WROMagnet/Tereneitor_PR/Parts/Pico Robot Expansion Board.png

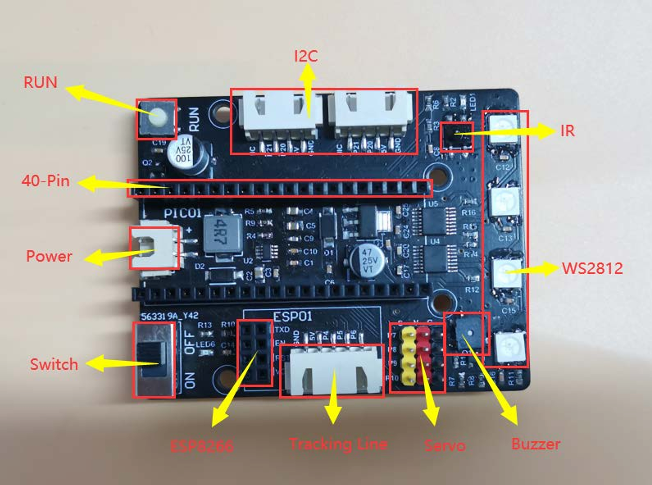
Parts/Pico Robot Expansion Board.png
