WROMagnet/Tereneitor_PR/Parts/Wheels x4.png

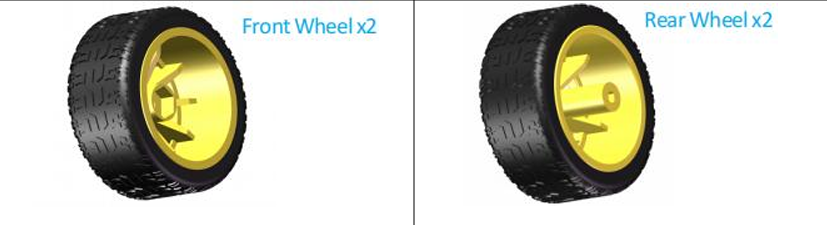
Parts/Wheels x4.png
