WROMagnet/Tereneitor_PR/README.md

# Tereneitor_PR | Future Engineers | Puerto Rico🤖

## Competitors of this team
- Daniel Roman Rodriguez - `18 years old`
- Luis Rios Santos - `18 years old`

## Content 📘  

| Folder  | Content| 
| -- | -- |
|
