WROMagnet/Tereneitor_PR/Parts/3.7V Lithium-ion batteries.jpg

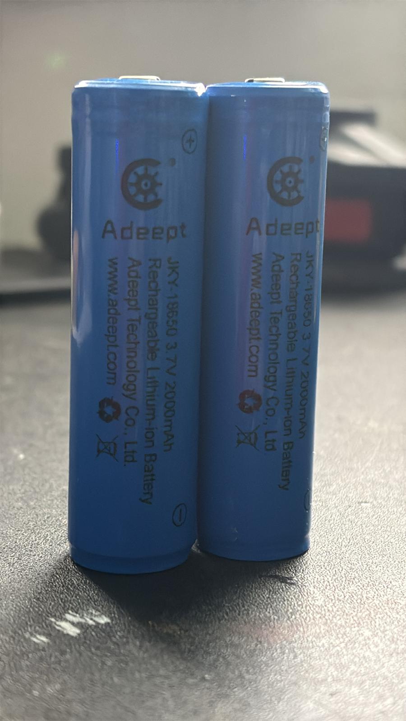
Parts/3.7V Lithium-ion batteries.jpg
