WROMagnet/Tereneitor_PR/Parts/Raspberry Pi Pico.png

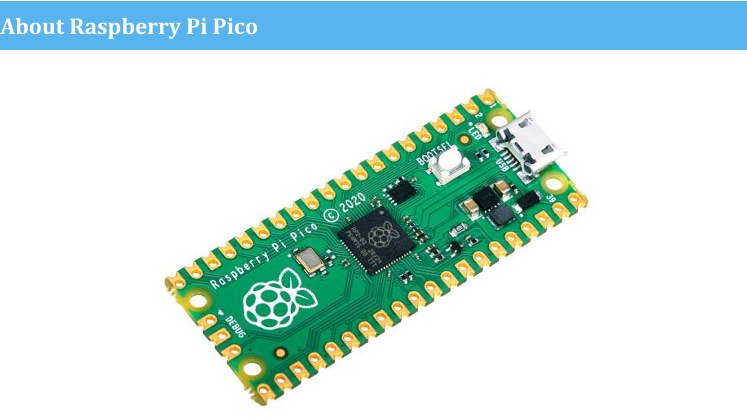
Parts/Raspberry Pi Pico.png
