WROMagnet/Tereneitor_PR/Parts/sensor TCS3200.jpg

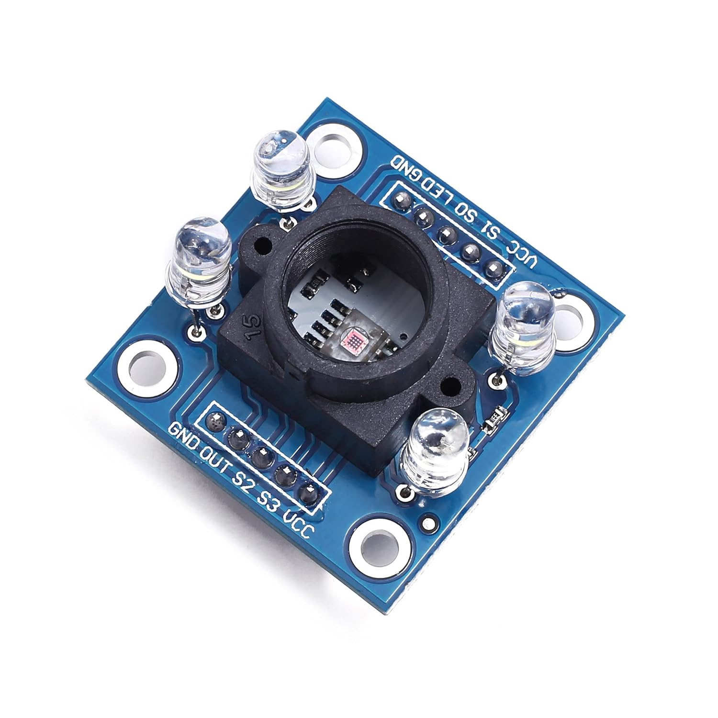
Parts/sensor TCS3200.jpg
