WROMagnet/Tereneitor_PR/3D Models/Base below.stl

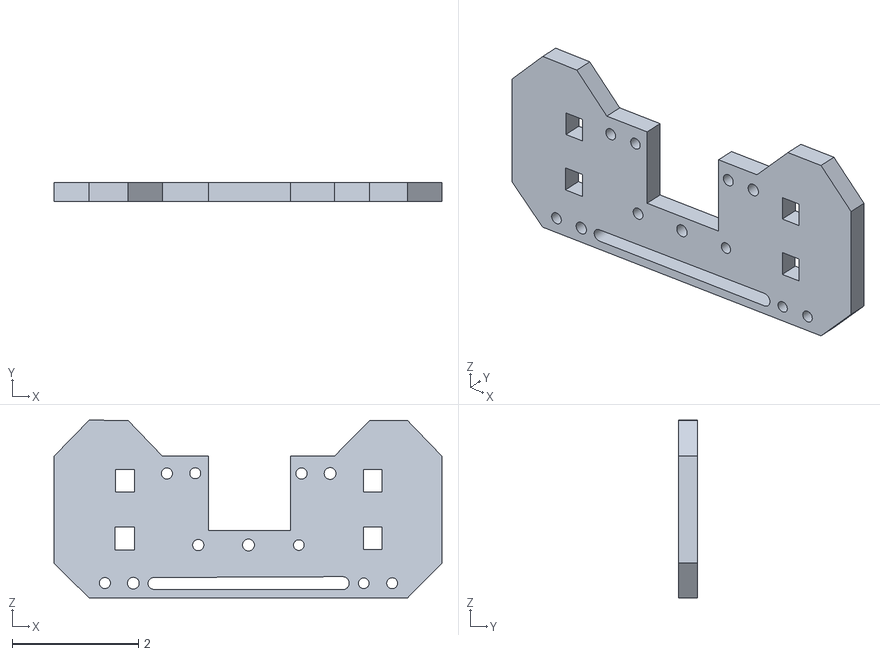
[picture p6: CAD file, 2025-03-30]
3D Models/Base below.stl
6.15 x 0.3 x 2.82
