WROMagnet/Tereneitor_PR/3D Models/Differential connectors/connectors.stl

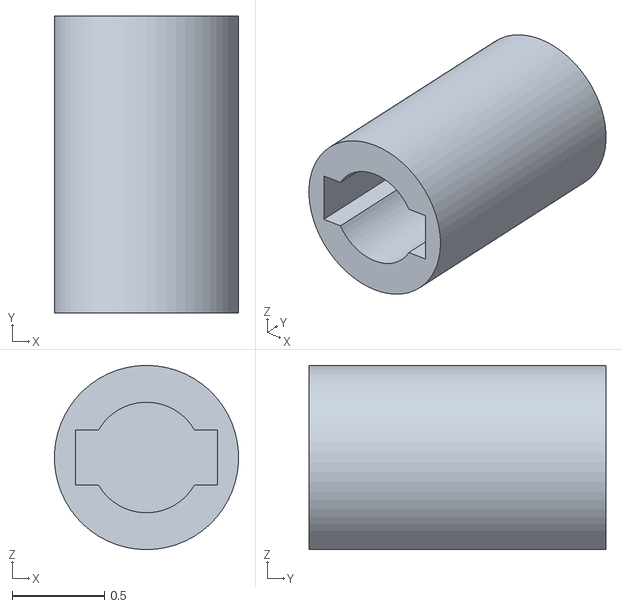
[picture p7: CAD file, 2025-02-20]
3D Models/Differential connectors/connectors.stl
0.999 x 1.61 x 1.00
