WROMagnet/Tereneitor_PR/3D Models/Front_ultrasonic_sensor_base.stl

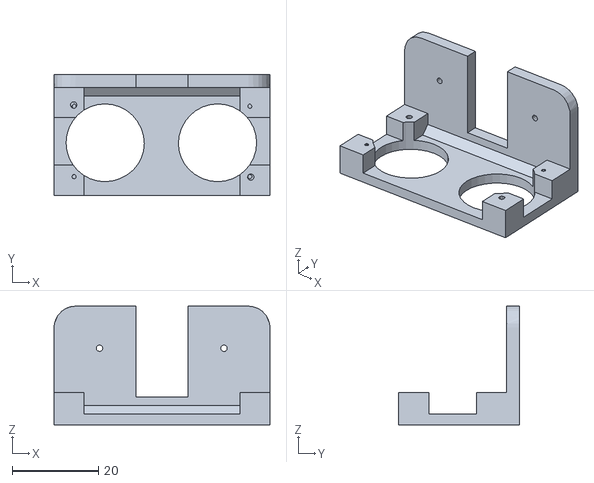
[picture p8: CAD file, 2025-01-18]
3D Models/Front_ultrasonic_sensor_base.stl
50.0 x 28.0 x 27.5
