WROMagnet/Tereneitor_PR/3D Models/Differential connectors/connectors (3).stl

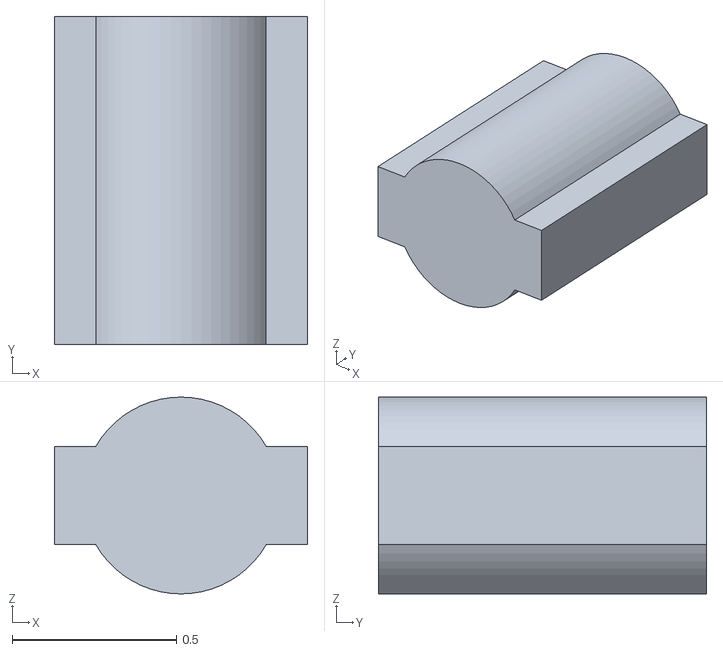
[picture p9: CAD file, 2025-02-20, an earlier design]
3D Models/Differential connectors/connectors (3).stl
0.772 x 1.00 x 0.6
