WROMagnet/Tereneitor_PR/3D Models/Differential connectors/connectors (2).stl

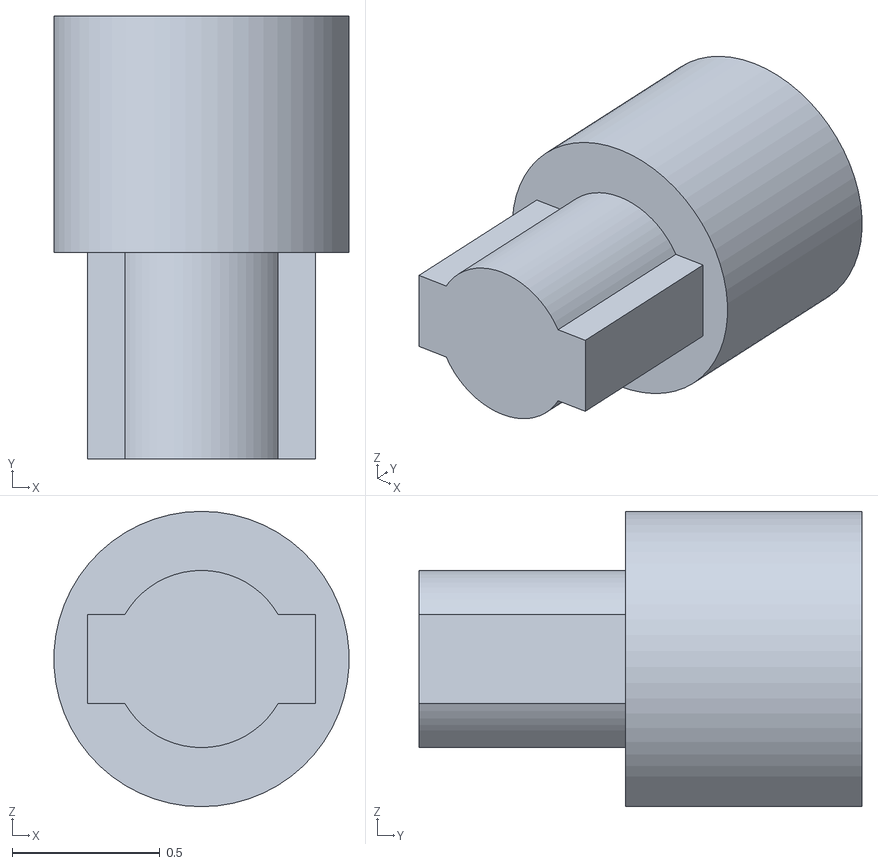
[picture p10: CAD file, 2025-02-20, an earlier design]
3D Models/Differential connectors/connectors (2).stl
0.999 x 1.50 x 1.00
