WROMagnet/Tereneitor_PR/(threads)

Thread 1 (2025-01-14):

Looking for ideas for chassis mount Day #1

WROMagnet, 2025-01-14:
### Today, December 27, we talked as a team to compete again in 2025 in WRO in future engineers, since in 2024 we participated, we have decided to participate this year again.

- This year we will be making a new robot for the competition, and we have been looking for different reference kits that we can use to create our robot. We have obtained a kit from the company _"Adeept"_ the kit model is `ADR033`.

WROMagnet, 2025-01-14:
- We have thought about buying the kit since it is the most complete one, we could find.But you would have to modify the car to be able to compete in WRO in future engineers.

### The kit :

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

- This is the kit we plan to buy to create our robot. The dimensions of this robot are within the size that WRO allows us, so it can be used. We will be purchasing this kit as the WRO rules do not allow it. Rule `11.18` states `(The vehicle may be built using any type of hardware kits and any materials; there are no restrictions on a specific type or special construction system)`.

WROMagnet, 2025-01-14:
_**Okay so we're going to buy this kit to use for racing this year.**_

Closed 2025-01-14.

Thread 2 (2025-01-14):

Piece count of the Adeept ACR033 Day #2

WROMagnet, 2025-01-14:
### Today, January 11, 2025, we received the Adeept ACR033, so we will be seeing what parts it comes with and which ones we will use and which ones we will not use.

### Parts List :

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

- This is the list of all the parts that this kit comes with.

WROMagnet, 2025-01-14:
- Of all the pieces it comes with, we only use a few, and not all of them are suitable for this competition.

### Pieces we will use :

- Raspberry Pi Pico
-  Pico Robot Expansion Board
-  OLED Screen
-  SR-04 Ultrasonic Module
-  18650 Battery holder
-  ESP8266 module
- Servo
- DC Motor
- Rear wheels
- Front Wheels
- Chassis A12, A11, A04, A05, A06, A02, A01, A03, A10, A09
- Connects cables

**All these parts are the ones you use from this kit and in the course, we will add more parts in your modification.**

Closed 2025-01-14.

Thread 3 (2025-01-14):

Robot base mount Day #3

WROMagnet, 2025-01-14:
### Today, January 11, we began assembling our new robot.

- To start the mount, we will use :

### step 1

` M3*12CopperStandoffs x4 `
` A12 chassis `
` M3*8Screw x4 `
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

### step 2

` M3Nuts x10 `
` L18650x2 battery holder `
` M3*14 countersunk screws x5 `
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

WROMagnet, 2025-01-14:
` OLED Display `
` M2*8 screws x8 `
` M2*11 copper standoff x4`

### Step 3

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

` M3*30 screws x2`
` M3 nut x2`
` DC Motor`
`A09 chassis`
` M3*8 screws x4`
`A10 chassis`
`M3*30 copper standoffs x4`

### Step 4

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

WROMagnet, 2025-01-14:
` M3*8 screws x4`
` A09 chassis`
` A12 chassis`
` Wheel x2`

### Step 5

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

`M2*14 screws x2`
` A06 chassis `
` Servo`
`M2 nuts x2`

### Step 6

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

` M3*12 Copper standoffs x2 `
` A11 chassis `
` M3*8 screws x4 `

### Step 7

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

### Step 8

`M3*30 Copper Standoffs x4 `
` M3*8 Screws x4 `

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

WROMagnet, 2025-01-14:
### Step 9

` A04 x1 chassis`
` Rocker arm`

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
### _important note: Do not fully tighten the screws, otherwise the acrylic plate will not rotate freely._
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

### Step 10

` Spring washer x3`
` F624ZZ bearing x2 `
`A12, A02, A03, A05 chassis `
` M4*40 Screws x1 `
` M4 Nuts x1 `

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

WROMagnet, 2025-01-14:
### Step 11

`M3*18 Copper Standoffs x2 `
` M3*8 Screws `
`A12 chassis `

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

### Step 12

` Round head M2.5*4 screws in the servo package `
` F687ZZ bearing x2 `

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

### Step 13

` M3*8 Screws x4 `
` F687ZZ bearing x2 `

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

- **This is how our chassis would look once assembled. We have to make a modification to the DC motors since only one motor is allowed to move the rear tires or for both motors to be electrically and mechanically connected.**

- So we have work to do, as we have already assembled the chassis we only need to modify the DC motors, place the Pico controller and its extension and the ultrasonic sensor.

Closed 2025-01-14.

Thread 4 (2025-01-17):

continuation of the mount Day #4

WROMagnet, 2025-01-17:
### Today, January 17, we will continue with the robot mount. Today we will add the controller and the different sensors that we will use.

- After having our robot like this, we make some holes in the front to place some sensors.

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

- The holes that are marked in green are for placing a base for an ultrasonic sensor and those that are marked in orange are for a solo sensor that will be looking at the ground.

WROMagnet, 2025-01-17:
- Before placing the sensors, I will mount the Raspberry Pi Pico, which is the controller that comes with this kit and the one we will use. To do this, we have to place the expansion board that it comes with.

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

- These marks are where the screws are placed to hold the Raspberry Pi Pico extension.

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

- This is how the Raspberry Pi Pico extension looks mounted on the robot.

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

- This connector connects our robot battery, which this kit includes 2 rechargeable 3.7V 2000mAh Lithium-ion batteries which are connected in series to add the voltage of the two batteries to have a voltage of 7.4V 2000mAh.

`3.7V` + `3.7V` = `7.4V`

- **To connect batteries in series, you must connect the positive of one battery to the negative of the other battery and use the remaining positive and negative and connect them to the device, which in this case is almost our Raspberry Pi Pico extension.**

WROMagnet, 2025-01-17:
- After connecting the battery we can place our Raspberry Pi Pico in our extension. The Micro USB port should be on the side where the battery connector is on the extension.

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

- Then we will take the opportunity to connect our motors, servo motor and our screen.

**Engines**
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

**servomotor**
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

**Screen**
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

WROMagnet, 2025-01-17:
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
- This is what our controller should look like so far.

- Now we will place our color sensor on the front of our robot pointing towards the ground.
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

- These marks are where the pins are to connect the sensor to the Raspberry Pi Pic, which we will use only the ports: S0, S1, S2, S3, GND and VCC.

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

The ports I connected the color sensor to were as follows:
- S0 = P10
- S1 = P9
- S2 = P17
- S3 = P16
- OUT = P8

- **I had to solder the out S0 and S1 directly to the raspberry pi pico in the ports.**

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

WROMagnet, 2025-01-17:
- Now we will put the front ultrasonic sensor on which we print a 3D piece which is the support for the ultrasonic sensor. The sensor with the sensor already placed looks like this.

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

- We will put some extensions upwards to place the sensor on top of those extensions.

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

- In this area the base that we created is placed upside down so that it does not look floating.

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

-  This is how it would be placed in the robot.

- **We will then mount the side ultrasonic sensors to measure the distance from the track walls. Which we created another base for the side sensors so they wouldn't take up so much space.**

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

- These are the bases we created for the sensors.

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

- We made these holes so that the bases can stay in place. We made these holes so that the bases can stay in place.

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

- This is how the bases were already assembled. We made the base like this so that it would not take up space since if we used the blue bases it would hit the rubber when turning, but with this base we solved that problem.

WROMagnet, 2025-01-18:
- Hello, we placed the sensors on the bases and it would look like this.

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

- We put a plastic wrap on the cables that comes with the kit to organize the cables. As you can see in the photo, the sensor cables are organized.

- _So far with the robot assembly, now we have to start programming to see if everything is in order and see if everything works._

Closed 2025-01-18.

Thread 5 (2025-01-20):

Ultrasonic sensor replacement Day #5

WROMagnet, 2025-01-20:
### Today, January 20, we thought that the robot, having green bases, the robot looked as if that were a problem since those bases did not fit with the base since it looked out of place and we thought since we have two bases of the other blue model, why don't we make some holes near the ball houses to place some small towers to raise the base and the sensor would not collide with the rubbers.

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

- In those areas were where the holes were made to place the sensors.

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

- This is how the side ultrasonic sensors turned out. We plan to place a front one but we have to print another blue base.

WROMagnet, 2025-01-20:
- **The pins to which the ultrasonic sensors are connected.**

`Left sonsor`
- trig   = P5
- echo = P4

 `Right sensor`
- trig   = P3
- echo = P2

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

WROMagnet, 2025-01-24:
### _That's the only thing we've done today, next day we'll be looking at how we can implement a camera for the obstacles on the track._

Closed 2025-01-24.

Thread 6 (2025-01-29):

Changing the controller Day #6

WROMagnet, 2025-01-29:
### Today, January 26, we have verified that the Raspberry Pi Pico is not capable of processing images through a camera, so we have decided to change the Raspberry Pi Pico for a Raspberry Pi 3 B since the Raspberry Pi 3 B is capable of processing images and since we have an idea of   placing a camera on the robot, to place a camera on the robot we have to change it to a Raspberry Pi 3 B.

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

- The first thing we will do is remove our Raspberry Pi Pico and its expansion which came with the kit we bought to replace it with a Raspberry Pi 3 B.

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

- The screws on the extension that I had and the Raspberry Pi 3 B do not match completely, so we will have to move where the screws will be placed. Since the base of our robot already has a series of holes for some modifications, it will be easy for us to place the Raspberry Pi 3 B.

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

- After placing our Raspberry Pi 3 B, something we have to keep in mind is that the maximum input voltage of the Raspberry Pi 3 B is 5V since it does not have a voltage regulator like the Raspberry Pi Pico and Arduino do, so we have to add a voltage regulator since our voltage source is 7.4V and that could cause permanent damage to the Raspberry Pi 3 B. So we are using a voltage regulator chip numbered (GL7805) which function is to convert any voltage greater than 5v to an output of exactly 5v.

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

- The left pin is the pin where the positive battery is connected, the central pin is the GND and the right pin is the 5v output pin.

WROMagnet, 2025-01-30:
- Another important thing to keep in mind is that the Raspberry Pi 3 B does not come with a motor module, which is not capable of controlling the direction of DC motors. But to solve this small detail we will be using a motor module, which will help the Raspberry Pi 3 B to control the direction of the DC motors that the robot makes.

### "We are already informed of the new rule for this year 2025 which is that our robot must have only one motor and a differential so that the motor can move both tires at the same time but in this case we still do not have the differential so we will soon change the motors."

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

- This is the motor module we are using for our robot. We will be placing the motor module on the back of the robot.

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

WROMagnet, 2025-01-30:
**After finishing placing the motor module, we will make the connections for the sensors, servo motor, motors and screen.**

### Ultrasonic sensors:
- left
`Trig = GPIO 17`
`echo = GPIO 27`

- right
`Trig = GPIO 23`
`echo = GPIO 24`

### Servomotor:
`sign = GPIO 22`

### Screen:
`SDA = GPIO 2 I2C1 SDA`
`SCL = GPIO 3 I2C1 SCL`

### Engine module:
- left motor B
`INT3 = GPIO 26`
`INT4 = GPIO 16`

- right motor A
`INT1 = GPIO 5`
`INT2 = GPIO 6`

**These are all the connections we have made, we have not put the GND and VCC since the GND must always be connected to the GND and the VCC always has to be connected to 5v or 3v.**

WROMagnet, 2025-01-30:
### This is what our robot would look like after switching to the Raspberry Pi 3 B and connecting all the components that will be used.

- _We haven't installed the camera yet, but we'll be using a webcam soon._

Closed 2025-01-30.

Thread 7 (2025-02-02):

Raspberry pi ventilation Day #7

WROMagnet, 2025-02-02:
### Today, January 31, we have decided to put a fan on the Raspberry Pi 3 B so that the board does not get too hot and so that it does not burn. Also because when the board is not so hot it does not make an effort to run the operating system.

- We are planning to use a fan from a medium sized computer that we found in the workshop. For the moment we will use that fan, but we are thinking of looking for a special fan for Raspberry Pis that have a heatsink and we could put thermal paste on it for better cooling of the board.

WROMagnet, 2025-02-02:
- The fan we are using measures 4.5cm x 4.5cm. It is a fan that does not take up the entire Raspberry Pi 3 B but cools half of the Raspberry Pi, which does not cause any problems since we only need it to cool the chips on the board, which causes the board to increase its temperature. Once those chips are cooled, the board decreases its temperature. It is a fan that supports 12v which we have no problem with since the highest voltage we have in the robot is 7.4v which cools the board enough so we have no problems with that.

- We are still planning to change the Raspberry Pi 3 B to a Raspberry Pi Zero 2 W which is more compact and we would have space to add additional things.But those changes will be later since we do not yet have the parts available today.

WROMagnet, 2025-02-20:
- As we changed the board we used again, the fan is no longer necessary since the Raspberry Pi Zero does not reach high temperatures enough to need a fan. The ports on the Raspberry Pi 3 B are the same as those on the Raspberry Pi Zero, so the connections remain on the same ports.

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

- This Raspberry pi Zero has a mini HDMI which requires an adapter or to buy a space cable.

- The Raspberry Pi Zero only has one USB port, which is the micro USB, and to connect a keyboard and mouse you need to buy an adapter.

WROMagnet, 2025-02-20:
**Well after connecting all the cables and connecting the battery to the Raspberry Pi Zero we have to download the Raspberry Pi OS operating system.**

- For this we must enter the official Raspberry Pi page and look for the Software option.
( https://www.raspberrypi.com/ )

- We are going to find the Raspberry pi image and download it to our computer.
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

- After downloading it, we install it on our computer and then we will choose the options that correspond to our board, which in this case is the Raspberry Pi Zero. We choose the recommended operating system and we choose the micro SD memory, which is the one that will have the operating system. The micro SD memory must be greater than 8GB to have enough space to download libraries and the programming program and other tools.

WROMagnet, 2025-02-20:
- Well after the operating system is downloaded we place the micro SD in the Raspberry Pi Zero and it would be ready to turn on.

**Well that's all for today. The next step will be to modify the rear tire mechanism a little since only one engine can be used. And we will be adding a few things to follow the competition regulations.**

Closed 2025-02-20.

Thread 8 (2025-03-30):

rear-wheel drive modification Day #8

WROMagnet, 2025-03-30:
**Today, March 30th, after a long time without working on our robot, we will be modifying the rear-wheel drive to comply with the competition regulations. The rules state that the vehicle must only have one motor to move the tires through a differential.**

### We bought a rear differential for our robot. It's made of metal so the enggrams don't break or peel off due to friction.

- differentiator that we will use:
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

- gear you see in the engine:
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

WROMagnet, 2025-03-30:
### How does a differentiator work?

- A differential is a mechanism that allows a vehicle's wheels to rotate at different speeds when the car takes a curve.

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

- These images explain a little about the operation of the differentiator and the names of each of the components of the differentiator.

WROMagnet, 2025-03-30:
- Since this differentiator is not made for the tires we have on this car, we will be using 3D modeling to use a 3D printer to create adapters to be able to connect the tires we have to this differentiator.

- Here are some photos of what the adapters look like and how we install them.

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
- This adapter connects the rubber base directly to the differential.

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
- On the other side of the differential we put this adapter that will connect to this other one that is placed at the base of the rubber.
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

- This is what the complete assembled mechanism looks like:
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

Closed 2025-03-30.
